shishito314/GEMS/PCB-Files/Editing/GEMS_Shieldv5.step

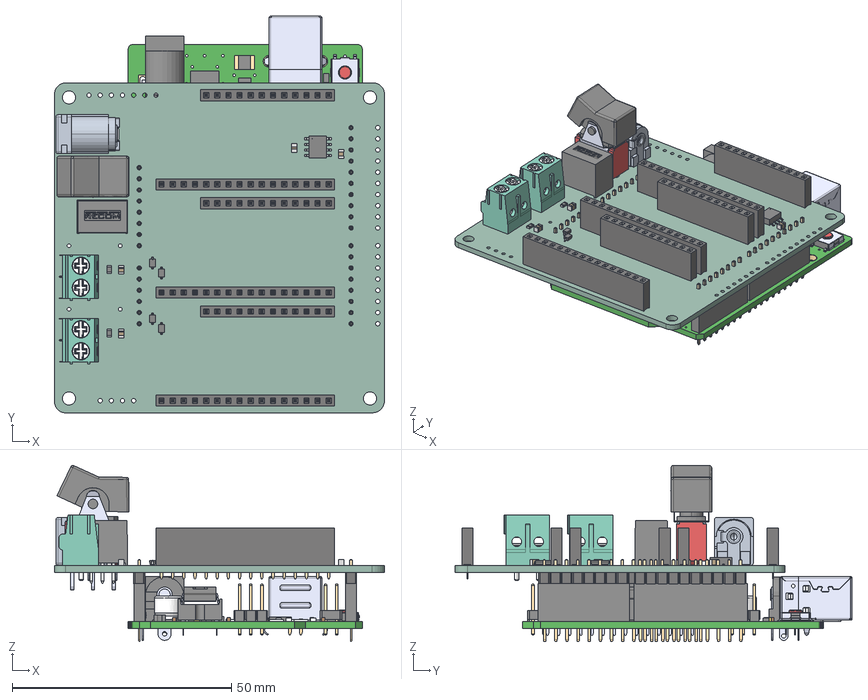
[picture p2: CAD file, 2025-07-30]
PCB-Files/Editing/GEMS_Shieldv5.step
75.2 x 90.4 x 40.1 mm
300SP1J1BLKM2QE
CAP_KGM21_KAV
CAP_CL21_SAM x 3
PinSocket_1x16_P2.54mm_Vertical x 3
RES_0816_SUS x 2
CR_SOD323_MCC x 4
CUI_DEVICES_PJ-037A
PinSocket_1x12_P2.54mm_Vertical x 3
A000066
R-78K5.0-1.0--3DModel-STEP-1
21-0041B_8_MXM
PinHeader_1x08_P2.54mm_Vertical x 2
PinHeader_1x10_P2.54mm_Vertical
PinHeader_1x06_P2.54mm_Vertical
GEMS_Shieldv5_PCB
