shishito314/GEMS/CAD-Files/GEMS_Case.step

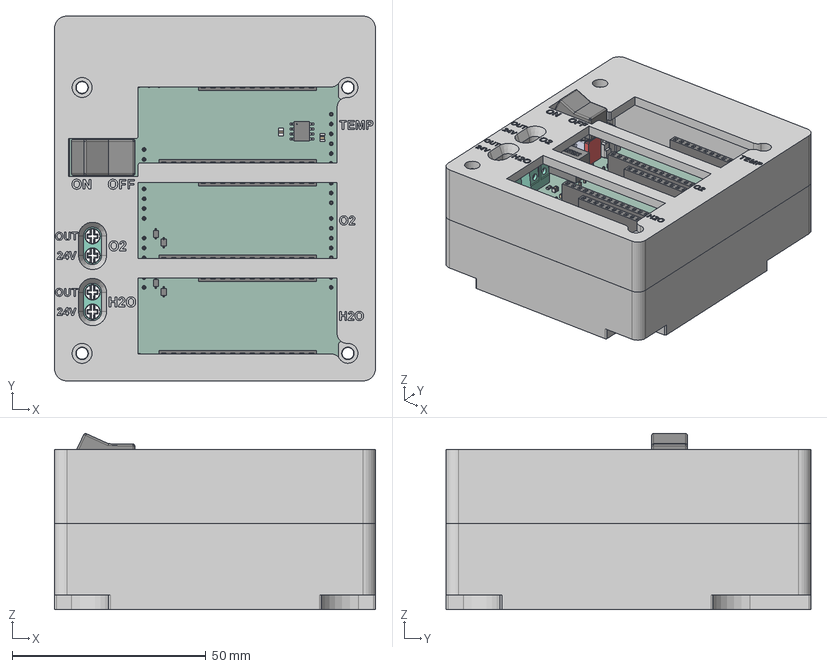
[picture p3: CAD file, 2025-08-19]
CAD-Files/GEMS_Case.step
82.8 x 94.1 x 45.4 mm
300SP1J1BLKM2QE
CAP_KGM21_KAV
CAP_CL21_SAM
PinSocket_1x16_P2.54mm_Vertical x 3
RES_0816_SUS x 2
CR_SOD323_MCC x 4
CUI_DEVICES_PJ-037A
PinSocket_1x12_P2.54mm_Vertical x 3
CAP_CL21_SAM_1 x 2
A000066
R-78K5.0-1.0--3DModel-STEP-1
21-0041B_8_MXM
PinHeader_1x08_P2.54mm_Vertical x 2
PinHeader_1x10_P2.54mm_Vertical
PinHeader_1x06_P2.54mm_Vertical
GEMS_Shieldv5_PCB
