shishito314/GEMS/CAD-Files/GEMS_Bottom_Case.stl

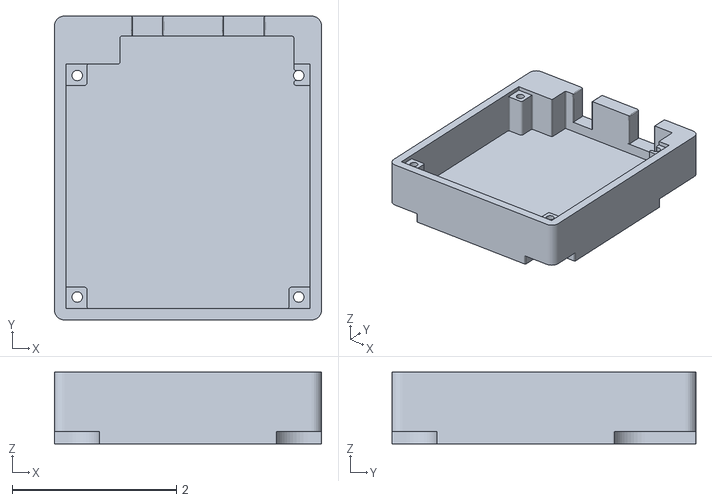
[picture p4: CAD file, 2025-08-19]
CAD-Files/GEMS_Bottom_Case.stl
3.26 x 3.71 x 0.873
