shishito314/GEMS/(list of files, cad)

Other CAD files:
CAD-Files/GEMS_Case.f3z
