shishito314/GEMS/PCB-Files/Editing/GEMS_Shieldv5.kicad_pcb

## KiCad design PCB-Files/Editing/GEMS_Shieldv5.kicad_pcb (2025-07-30)

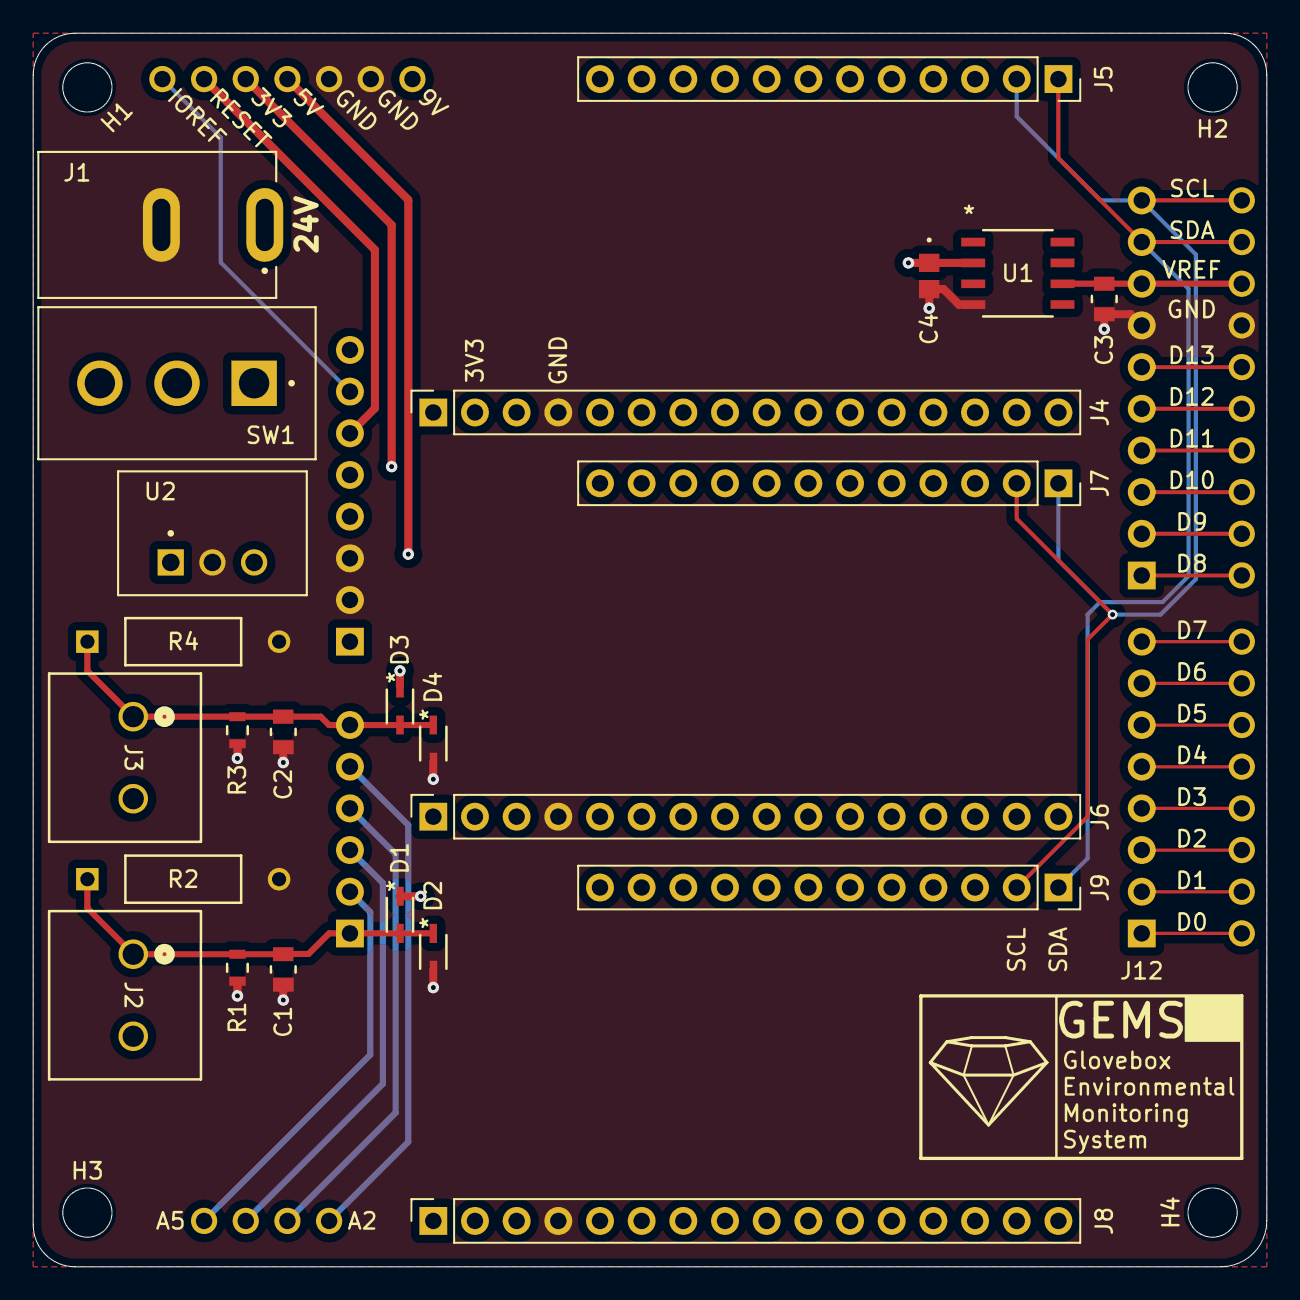
[picture p5: board GEMS_Shieldv5.kicad_pcb from above]

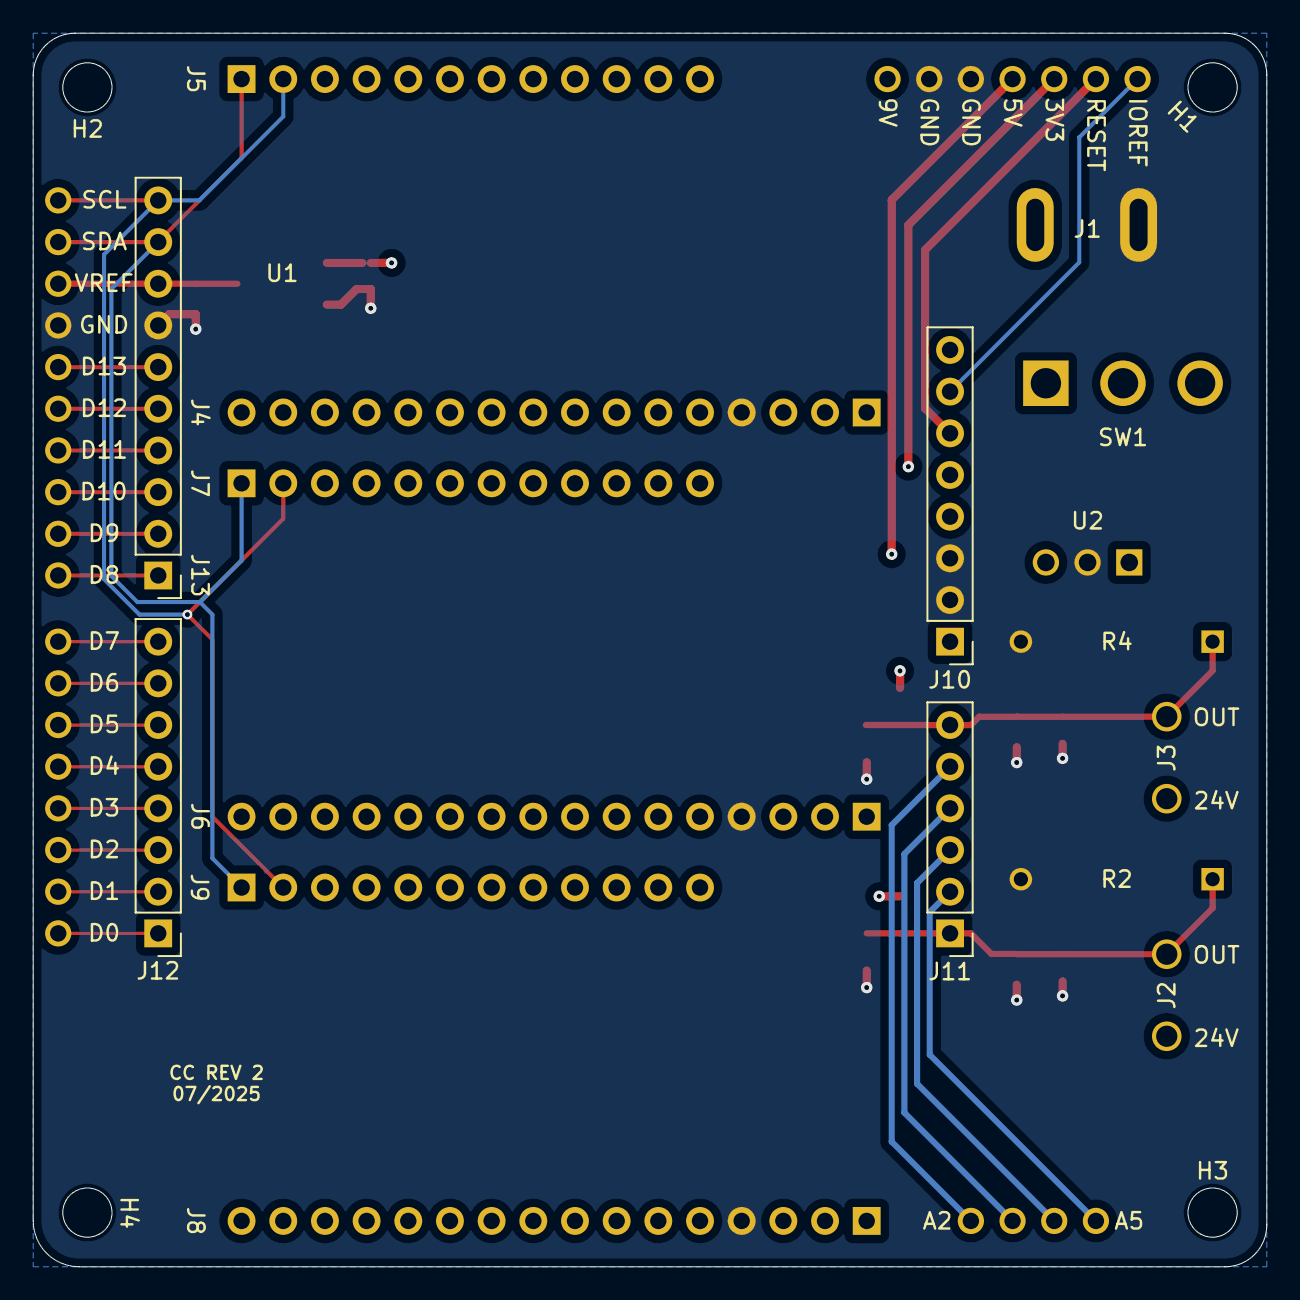
[picture p6: board GEMS_Shieldv5.kicad_pcb from below]

Board: 4 copper layers, 75.2 x 75.2 mm, 61 parts (4 on the bottom side), 10 nets.

Parts:
A1: Arduino_UNO_R3; Arduino_Wifi_Drawing
C1, C2: C; CL21A106KOQNNNE_10uF
C3: C; CL21B105KBFNNNE_1uF
C4: C; CAP_KGM21_KAV
D1, D2, D3, D4: D; CR_SOD323_MCC
H1, H2, H3, H4: MountingHole
J1: Barrel_Jack; CUI_PJ-037A
J2, J3: Screw_Terminal_01x02; CONN_1935161_PXC
J4, J6, J8: Conn_01x16_Socket; PinSocket_1x16_P2.54mm_Vertical
J5, J7, J9: Conn_01x12_Socket; PinSocket_1x12_P2.54mm_Vertical
J10, J12: Conn_01x08_Pin; PinHeader_1x08_P2.54mm_Vertical
J11: Conn_01x06_Pin; PinHeader_1x06_P2.54mm_Vertical
J13: Conn_01x10_Pin; PinHeader_1x10_P2.54mm_Vertical
J14, J15, J16, J17, J18, J19, J20, J21, J22, J23, J24, J25, J26, J27, J28, J29, J30, J31, J32, J34, J35, J36, J37, J38, J39, J40, J41, J42: Conn_01x01_Socket; THT_Connection
R1, R3: R; RES_0816_SUS
R2, R4: R; YAG_MF25_YAG
SW1: SW_SPDT; SW_300SP1J1BLKM2QE
U1: MAX6167AESA+; 21-0041B_8_MXM
U2: CONV_R-78K9.0-0.5

Connections:
+3.3V: J4.2, J6.2, J8.2, J10.5, J18.1
+5V: D1.1 (K), D3.1 (K), J10.4, J17.1
+9V: C4.1, J10.1, J14.1, U1.2 (IN), U2.3 (9V)
+24V: J1.1, J2.2, J3.2, SW1.1 (A), SW1.2 (B), U2.1 (24V)
GND: C1.2, C2.2, C3.2, C4.2, D2.2 (A), D4.2 (A), J1.2, J4.4, J6.4, J8.4, J10.2, J10.3, J13.7, J15.1, J16.1, J40.1, R1.2, R2.2, R3.2, R4.2, U1.4 (GND), U2.2 (GND)
unnamed: C1.1, D1.2 (A), D2.1 (K), J2.1, J11.1, R1.1, R2.1
unnamed: C2.1, D3.2 (A), D4.1 (K), J3.1, J11.6, R3.1, R4.1
unnamed: C3.1, J13.8, U1.6 (OUT)
unnamed: J5.1, J7.1, J9.1, J13.9, J41.1
unnamed: J5.2, J7.2, J9.2, J13.10, J42.1
