shishito314/GEMS/(commit log)

2024-08-26 Rename Full Assembly.step to CAD-Files/Full Assembly.step
    [Full Assembly.step]
2025-07-18 updated comments and readability
    [config.txt]
2025-07-23 Fixed Python and updated Arduino caching system
    [circularCache.h, config.h, loop.py, oxyWaterDisplay.ino, smoothing.h]
2025-07-30 PCB changes
    [GEMS_Shieldv3-B_Cu.gbr, GEMS_Shieldv3-B_Mask.gbr, GEMS_Shieldv3-B_Silkscreen.gbr, GEMS_Shieldv3-Edge_Cuts.gbr, GEMS_Shieldv3-F_Cu.gbr, GEMS_Shieldv3-F_Mask.gbr, GEMS_Shieldv3-F_Paste.gbr, GEMS_Shieldv3-F_Silkscreen.gbr]
2025-08-19 CAD files and fixed Arduino code
    [Case.step, Full Assembly.step, GEMS_Bottom_Case.stl, GEMS_Case.f3z, GEMS_Case.step, GEMS_Top_Case.stl]
2026-07-28 readme update, makedirs fix, seven segment text display fix
    [config.h, getMacAddress.ino, oxyWaterDisplay.ino]
